W3AXL/Simple-GPSDO/kicad/simple-gpsdo-PCB-revD.png

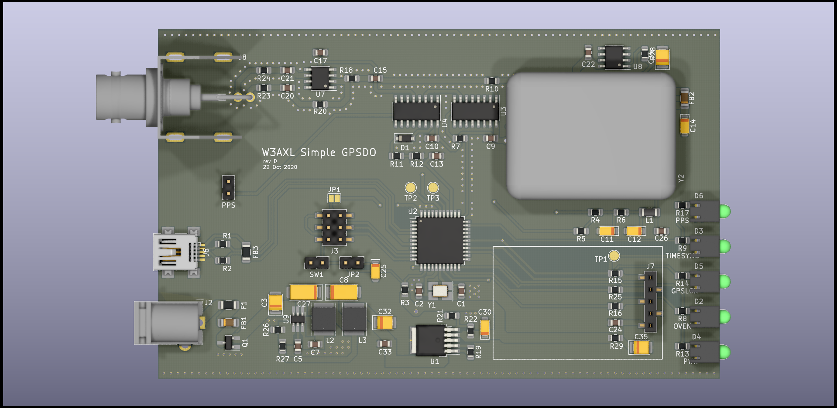
kicad/simple-gpsdo-PCB-revD.png
