W3AXL/Simple-GPSDO/kicad/board-model/board-revC.png

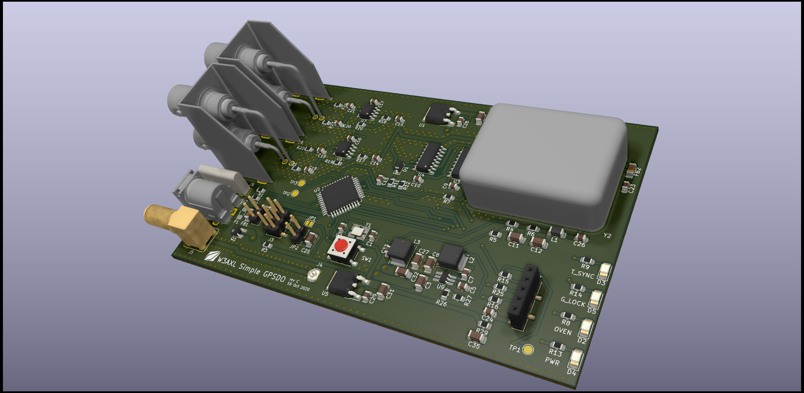
kicad/board-model/board-revC.png
