W3AXL/Simple-GPSDO/cad/render-back.png

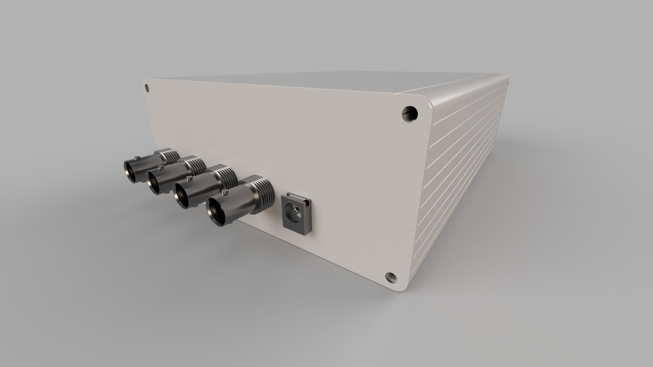
cad/render-back.png
