W3AXL/Simple-GPSDO/cad/render-front-2.png

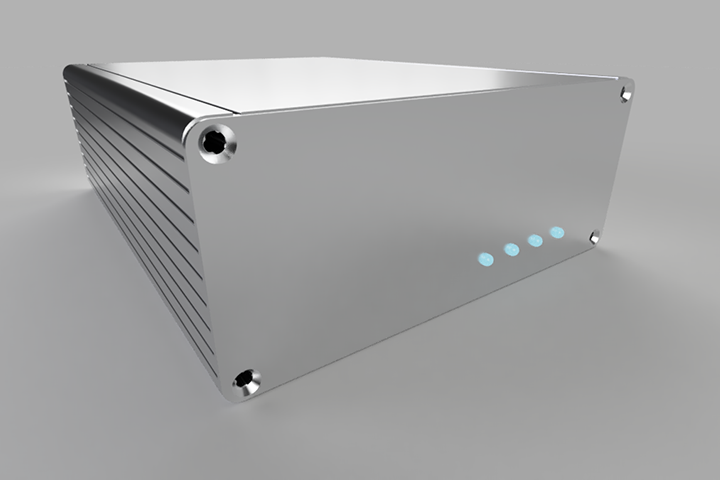
cad/render-front-2.png
