W3AXL/Simple-GPSDO/cad/render-front.PNG

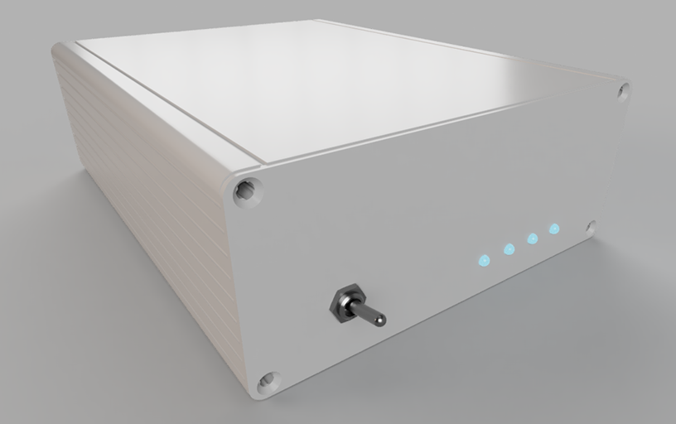
cad/render-front.PNG
