W3AXL/Simple-GPSDO/kicad/board-model/board-small.png

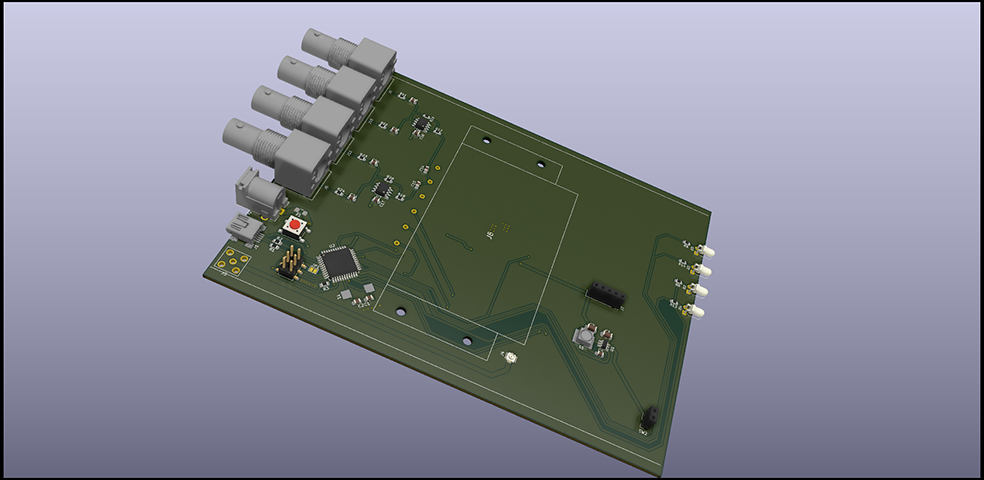
kicad/board-model/board-small.png
