W3AXL/Simple-GPSDO/cad/Enclosure Front Panel.stl

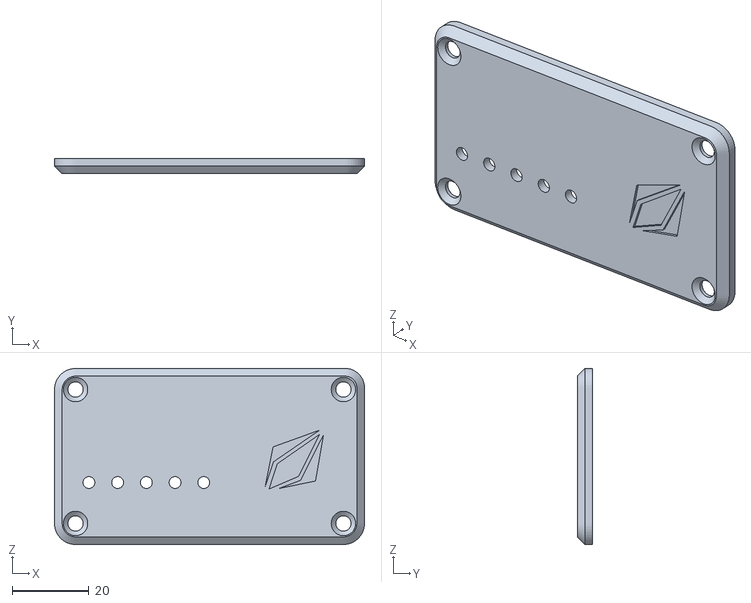
[picture p20: CAD file, 2021-11-03]
cad/Enclosure Front Panel.stl
81.0 x 4.00 x 46.0
