W3AXL/Simple-GPSDO/kicad/3d/934CB.STEP

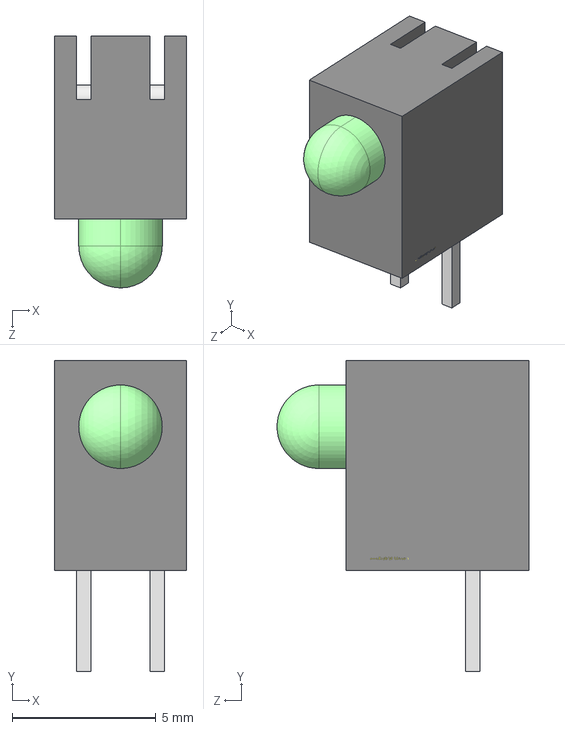
[picture p21: CAD file, 2021-10-23]
kicad/3d/934CB.STEP
4.60 x 10.8 x 8.75 mm
