W3AXL/Simple-GPSDO/kicad/HI1206P121R-10_LRD.step

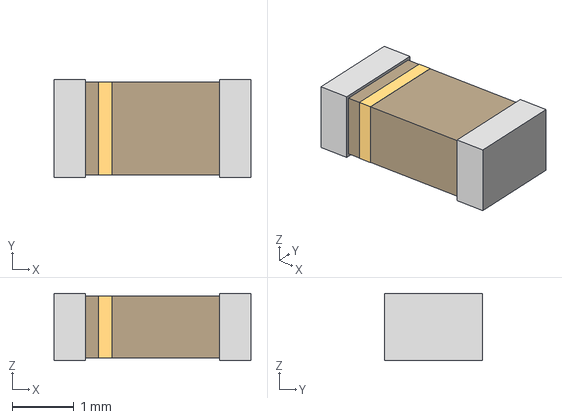
[picture p22: CAD file, 2020-09-25]
kicad/HI1206P121R-10_LRD.step
3.20 x 1.60 x 1.09 mm
