W3AXL/Simple-GPSDO/cad/Enclosure Rear Panel.stl

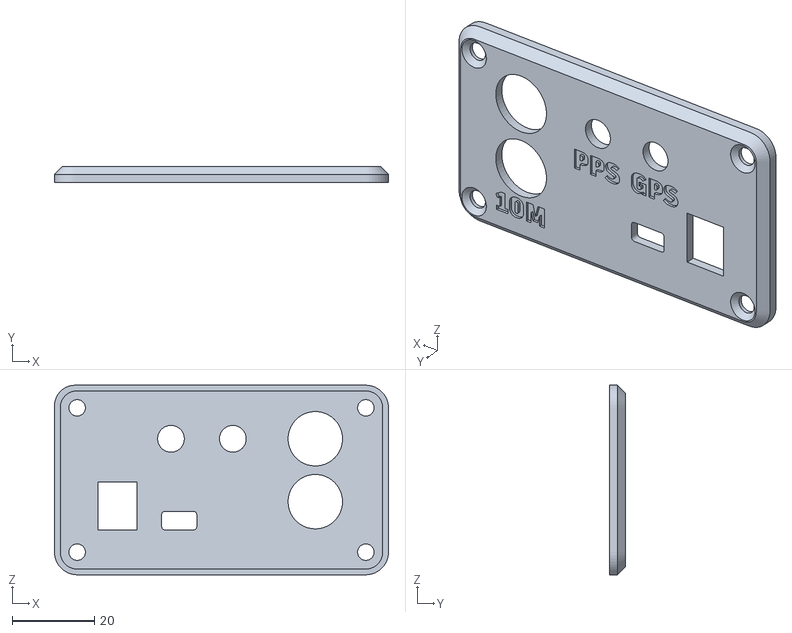
[picture p23: CAD file, 2021-11-03]
cad/Enclosure Rear Panel.stl
81.0 x 4.00 x 46.0
