W3AXL/Simple-GPSDO/kicad/Bliley NV47X v1.step

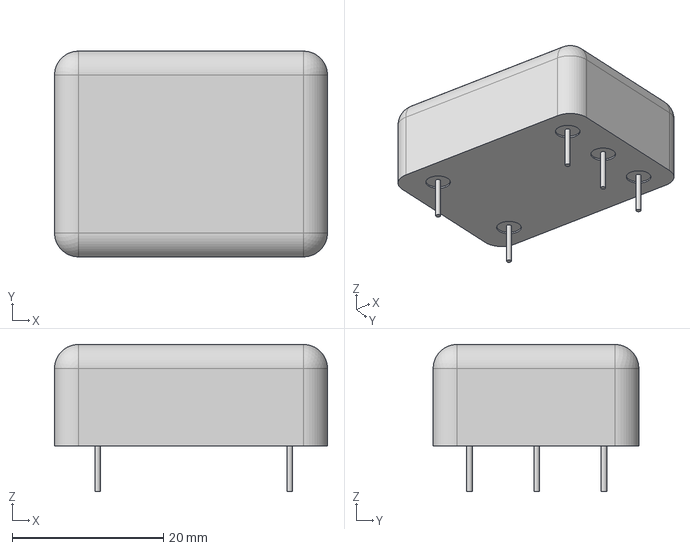
[picture p24: CAD file, 2020-09-24]
kicad/Bliley NV47X v1.step
36.1 x 27.2 x 19.5 mm
