W3AXL/Simple-GPSDO/cad/c-3-1478955-0-c-3d.stp

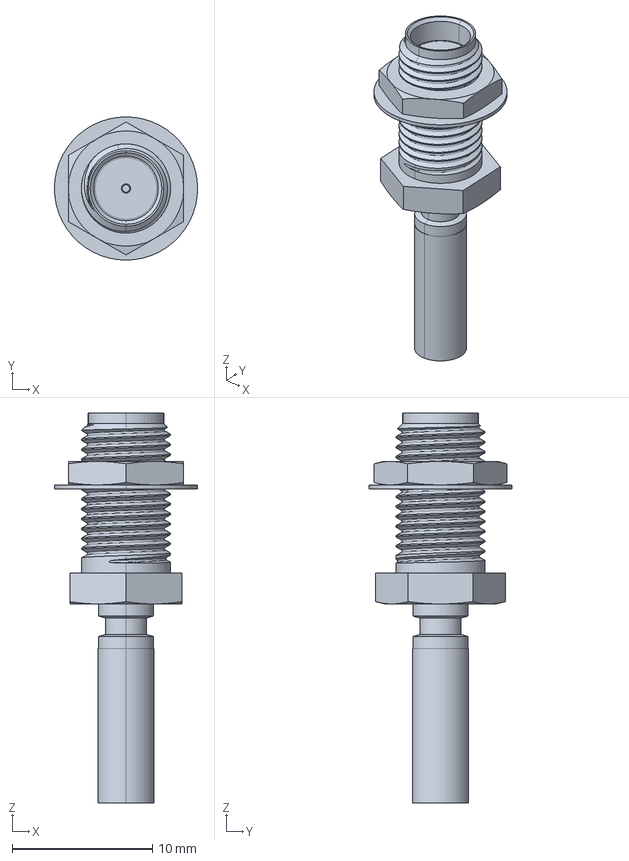
[picture p25: CAD file, 2021-10-23]
cad/c-3-1478955-0-c-3d.stp
10.2 x 10.2 x 27.8 mm
