W3AXL/Simple-GPSDO/kicad/RF2-49B-T-00-50-G-HDW v8.step

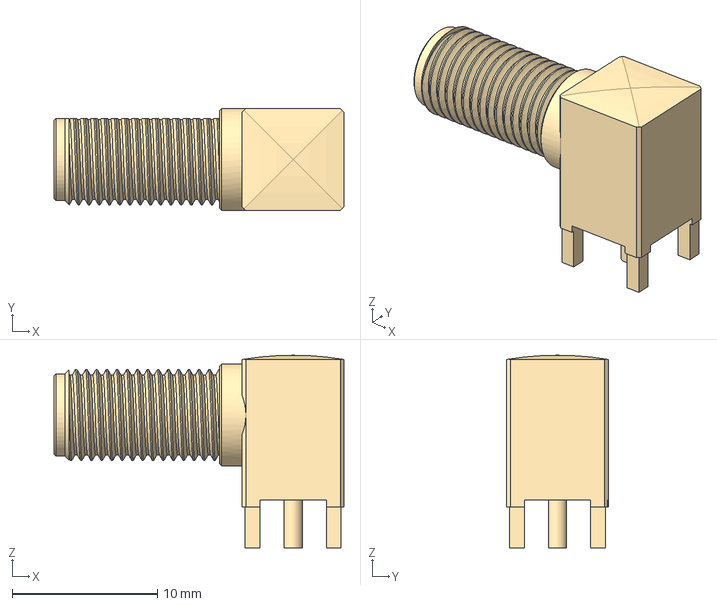
[picture p26: CAD file, 2020-09-24]
kicad/RF2-49B-T-00-50-G-HDW v8.step
20.0 x 7.01 x 13.3 mm
