W3AXL/Simple-GPSDO/cad/Q End Panel.stp

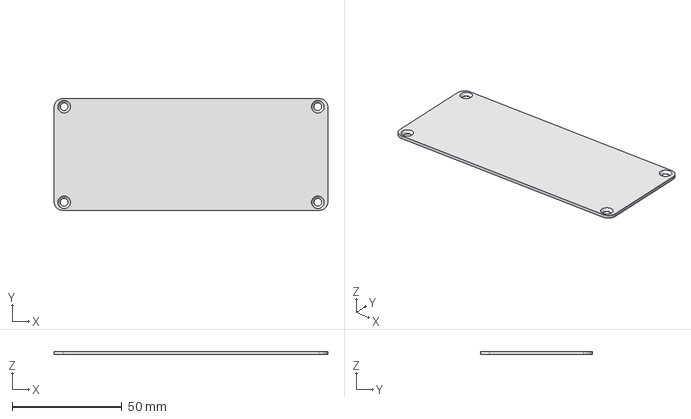
[picture p27: CAD file, 2020-09-19]
cad/Q End Panel.stp
124.8 x 50.9 x 1.45 mm
