W3AXL/Simple-GPSDO/kicad/IND_NRS5030_TAY.step

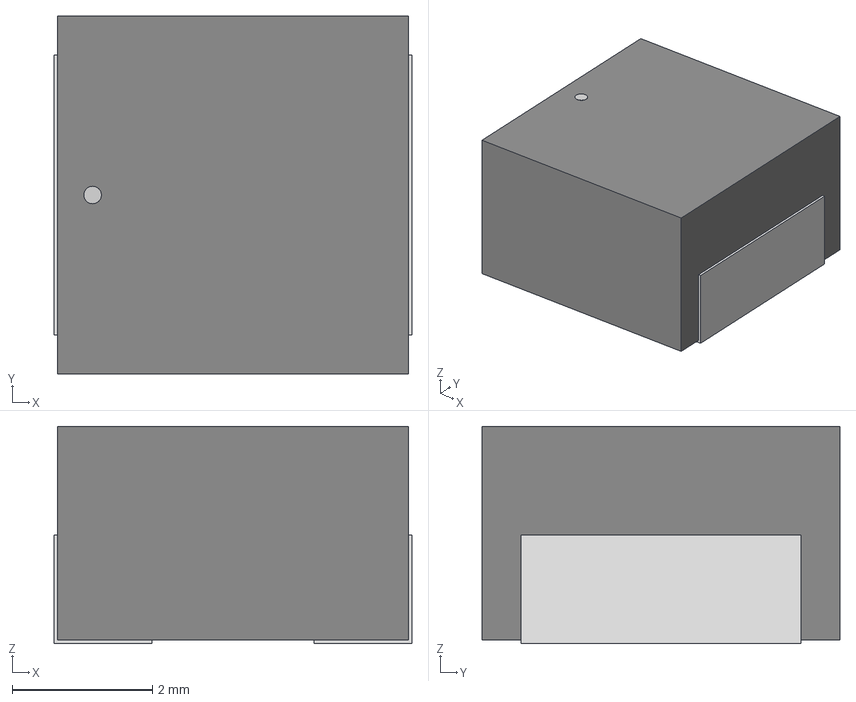
[picture p28: CAD file, 2020-09-24]
kicad/IND_NRS5030_TAY.step
5.11 x 5.11 x 3.10 mm
