W3AXL/Simple-GPSDO/cad/Q Bezel Open.stp

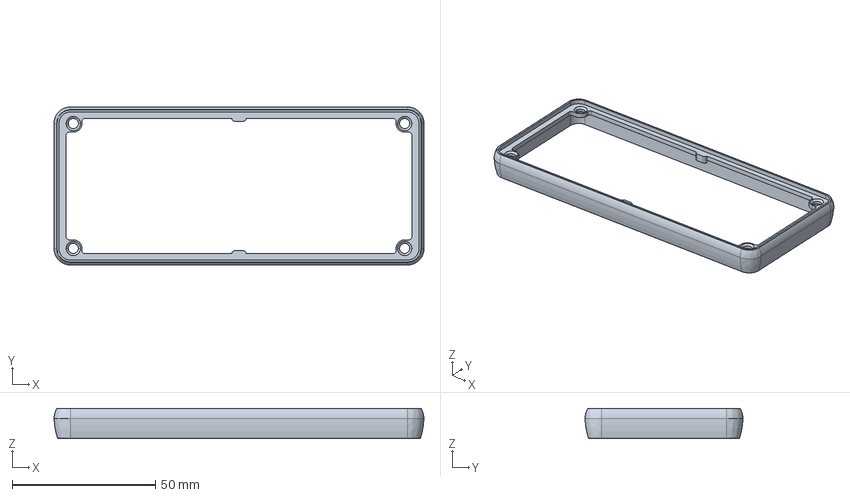
[picture p29: CAD file, 2020-09-19]
cad/Q Bezel Open.stp
129.0 x 55.1 x 10.5 mm
