W3AXL/Simple-GPSDO/cad/Q Extrusion 160mm.stp

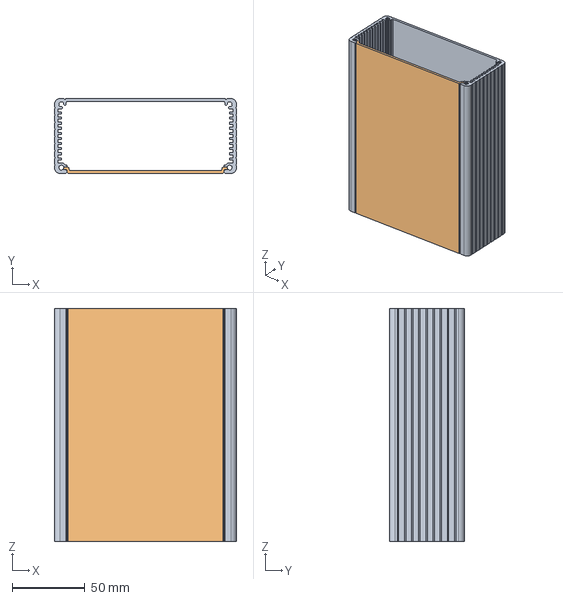
[picture p30: CAD file, 2020-09-19]
cad/Q Extrusion 160mm.stp
125.0 x 51.5 x 160.0 mm
