W3AXL/Simple-GPSDO/kicad/KUSBX-SL-CS1N14-B v8.step

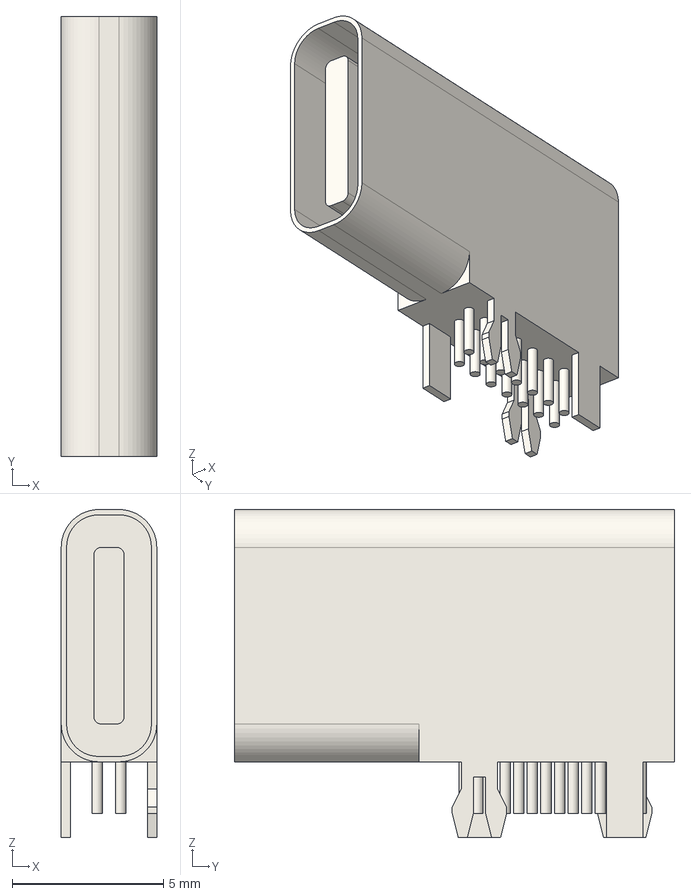
[picture p31: CAD file, 2020-09-24]
kicad/KUSBX-SL-CS1N14-B v8.step
3.16 x 14.6 x 10.8 mm
