W3AXL/Simple-GPSDO/kicad/3d/65100516121.stp

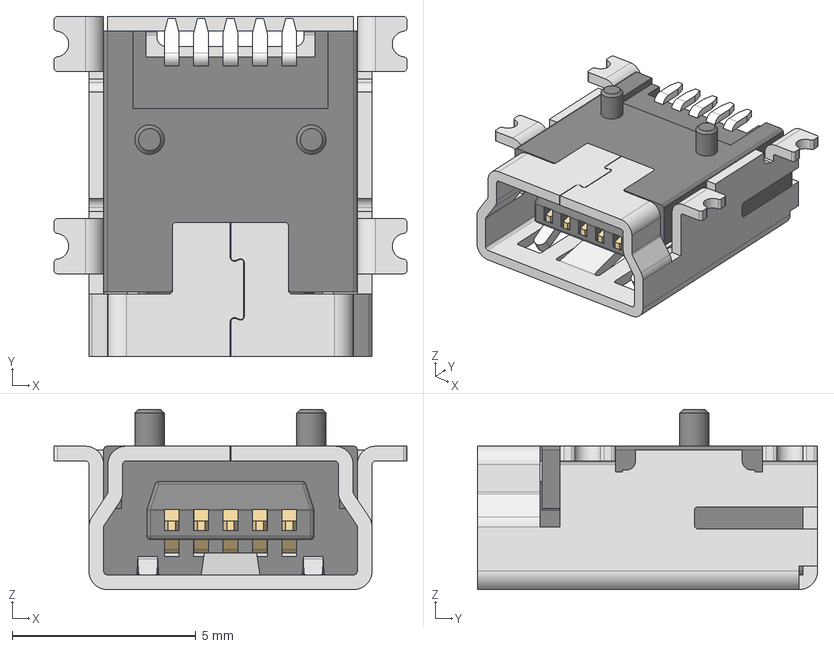
[picture p32: CAD file, 2021-10-23]
kicad/3d/65100516121.stp
9.60 x 9.25 x 4.90 mm
Shielding
Insulator
Pin_1 x 5
