W3AXL/Simple-GPSDO/cad/1455K1201.stp

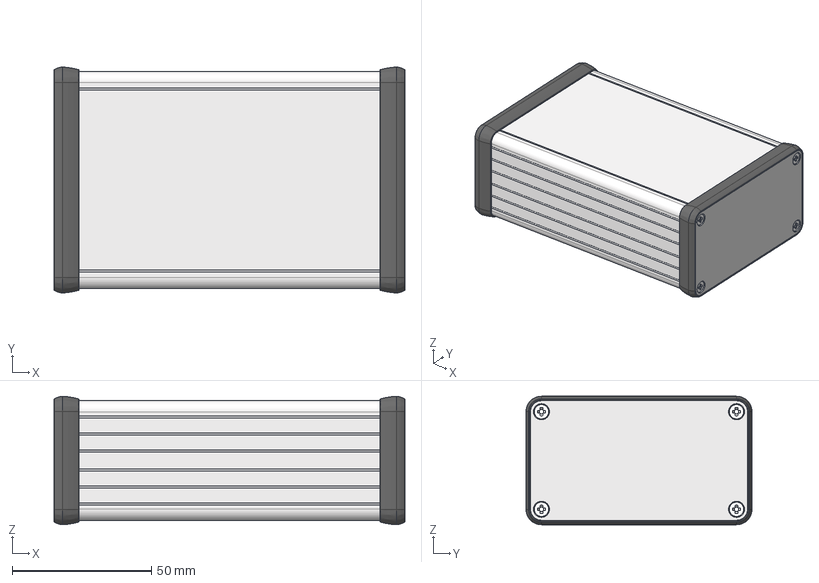
[picture p33: CAD file, 2020-09-24]
cad/1455K1201.stp
126.0 x 81.1 x 46.1 mm
K Channel Extrusion 120mmt
K Cap Extrusion 120mm
K Bezel Open x 2
K End Plate x 2
1455 screw x 8
