W3AXL/Simple-GPSDO/kicad/734153980.stp

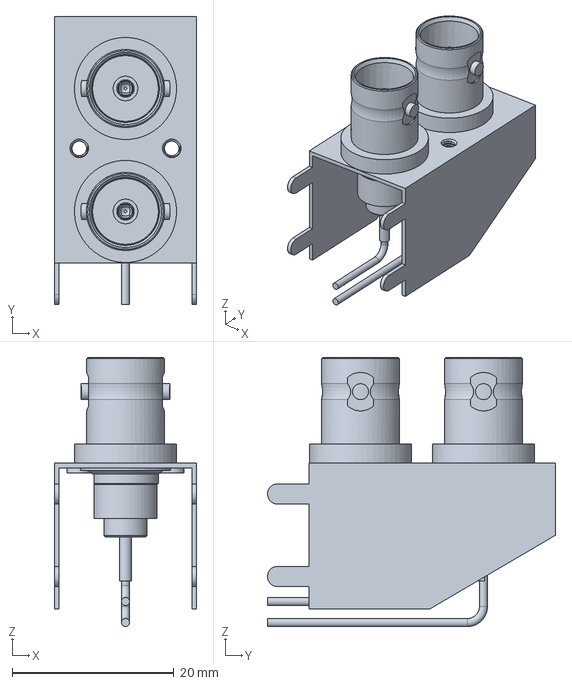
[picture p34: CAD file, 2020-09-24]
kicad/734153980.stp
17.6 x 35.6 x 33.3 mm
