W3AXL/Simple-GPSDO/(list of files, cad)

Other CAD files:
kicad/RF2-49B-T-00-50-G-HDW.stl
kicad/KUSBX-SL-CS1N14-B v6.step
