W3AXL/Simple-GPSDO/Pin Changes for rev B.txt

Pin Changes for rev B

PD6 (26) - New 5MHz Input
PD4 (25) - New PPS Input

PC6 (31) - New POWER_OK LED
PB4 (28) - New GPS_LOCK LED
PD1 (19) - New OVEN_TEMP LED
