W3AXL/Simple-GPSDO/(threads)

Thread 1 (2020-09-24):

Schematic updates to rev C

W3AXL, 2020-09-24:
Ongoing list of updates needed to the rev C schematic/PCB

- [x] Switch 33uH inductor to 3.3uH to avoid control loop instability and noise pickup
- [x] Add additional filtering on output of buck converter (second 3.3uH inductor plus caps to ground)
- [x] Reverse Polarity Protection on 12V input (PFET)
- [x] PPS connector

W3AXL, 2020-09-24:
Checklist for closure of ticket:
- [ ] Schematic Updated, Error Checked, Footprints Assigned
- [ ] Board Updated, Layout Error Checked
- [ ] BOM updated with component changes/additions

W3AXL, 2020-09-25:
Couple more small changes suggested by dbldutch over at eevblog forums

- [ ] Small series resistor and capacitor inline with supply to NEO GPS module to reduce 1PPS bouncing
- [ ] Fan control circuit and unpopulated footprints
- [ ] Resistor + capacitor on data line of LM35

W3AXL, 2020-10-16:
Deferring fan control to a future revision

Closed 2020-10-16.
