W3AXL/Simple-GPSDO/kicad/sch/revE/simple-gpsdo.pdf

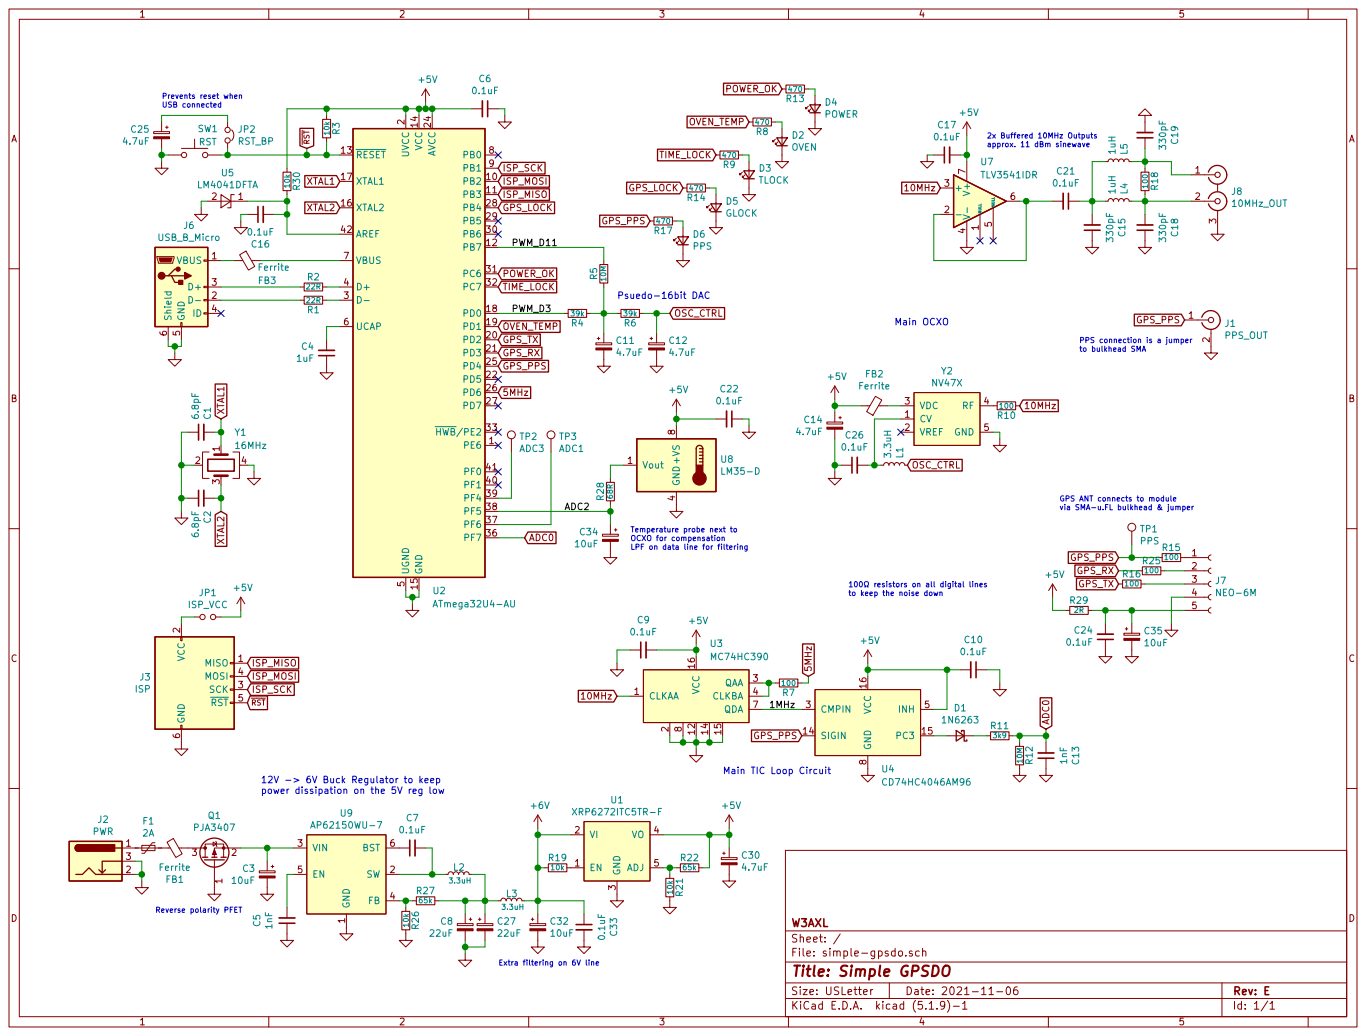
[picture p35: page 1]

2 PD2 20 PD3 21 PD5 22 AVCC 24 PD4 25 PD6 26 PD7 27 PB4 28 PB5 29 D- 3 PB6 30 PC6 31 PC7 32 HWB/PE2 33 PF7 36 PF6 37 PF5 38 PF4 39 D+ 4 PF1 40 PF0 41 AREF 42 UGND

2x Buffered 10MHz Outputs approx. 11 dBm sinewave

to bulkhead SMA Psuedo-16bit DAC

PPS connection is a jumper

GPS ANT connects to module
via SMA-u.FL bulkhead & jumper

100 resistors on all digital lines

2 SCK 3 MOSI 4 RST 5 GND

1 SW 2 VIN 3 FB 4 EN 5 BST 6 U9 AP62150WU-7 SIGIN 14 PC3 15 VCC 16 CMPIN 3

12V -> 6V Buck Regulator to keep
power dissipation on the 5V reg low

File: simple-gpsdo.sch Sheet: / W3AXL

Extra filtering on 6V line

Id: 1/1 Title: Simple GPSDO
