W3AXL/Simple-GPSDO/kicad/sch/revC/simple-gpsdo.pdf

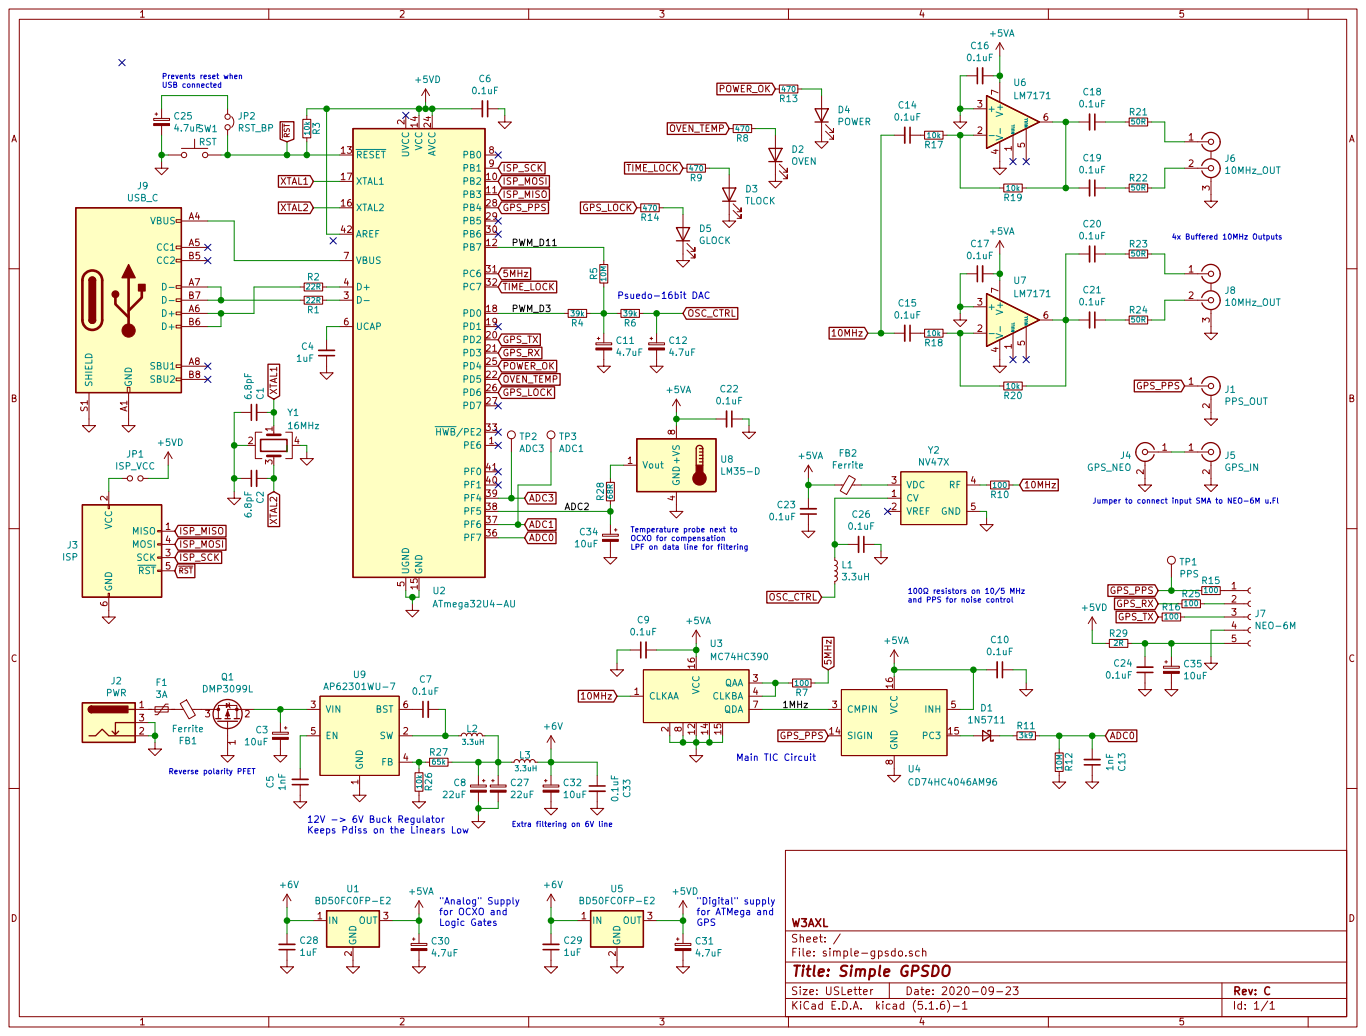
[picture p36: page 1]

Prevents reset when USB connected

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

Jumper to connect input SMA to NEO-6M u.Fl 4x Buffered 10MHz Outputs

2 SCK 3 MOSI 4 RST 5 GND

ISP_MISO
ISP_MOSI
LPF on data line for filtering Reverse polarity PFET
ISP_SCK
RST

100 resistors on 10/5 MHz and PPS for noise control 12V -> 6V Buck Regulator

1 SW 2 VIN 3 FB 4 EN 5 BST 6 U9 AP62301WU-7

Keeps Pdiss on the Linears Low

"Digital" supply
for ATMega and GPS

File: simple-gpsdo.sch Sheet: / W3AXL

Id: 1/1 Title: Simple GPSDO
