W3AXL/Simple-GPSDO/sim/Output Amplifier/output-amplifier-sim.asc

C4: cap; 0.1µ
C7: cap; 330p
C8: cap; 330p
C9: cap; 330p
L3: ind; 1µ; Rser=400m
L4: ind; 1µ; Rser=400m
R1: res; 50
R2: res; 50
R6: res; 100
U1: TLV354
V1: voltage; 5V
V2: voltage; PULSE(0 4 0 6n 6n 50n 100n); Rser=127
Named nets: 0, OUT1, OUT2, IN, +5V, SINE
.tran 0 100.5u 100u
