W3AXL/Simple-GPSDO/sim/OSC Control Amp/control-amp.asc

C1: cap; 4.7µ
C2: cap; 4.7µ
R1: res; 10Meg
R2: res; 39k
R3: res; 39k
R4: res; 100
V3: voltage; PULSE(0 5 0 0 0 1m 2m)
V4: voltage; PULSE(0 5 0 0 0 1m 2m)
Named nets: 0, DAC
.tran 5
