W3AXL/Simple-GPSDO/kicad/simple-gpsdo.kicad_pcb

## KiCad design kicad/simple-gpsdo.kicad_pcb (2021-11-11)

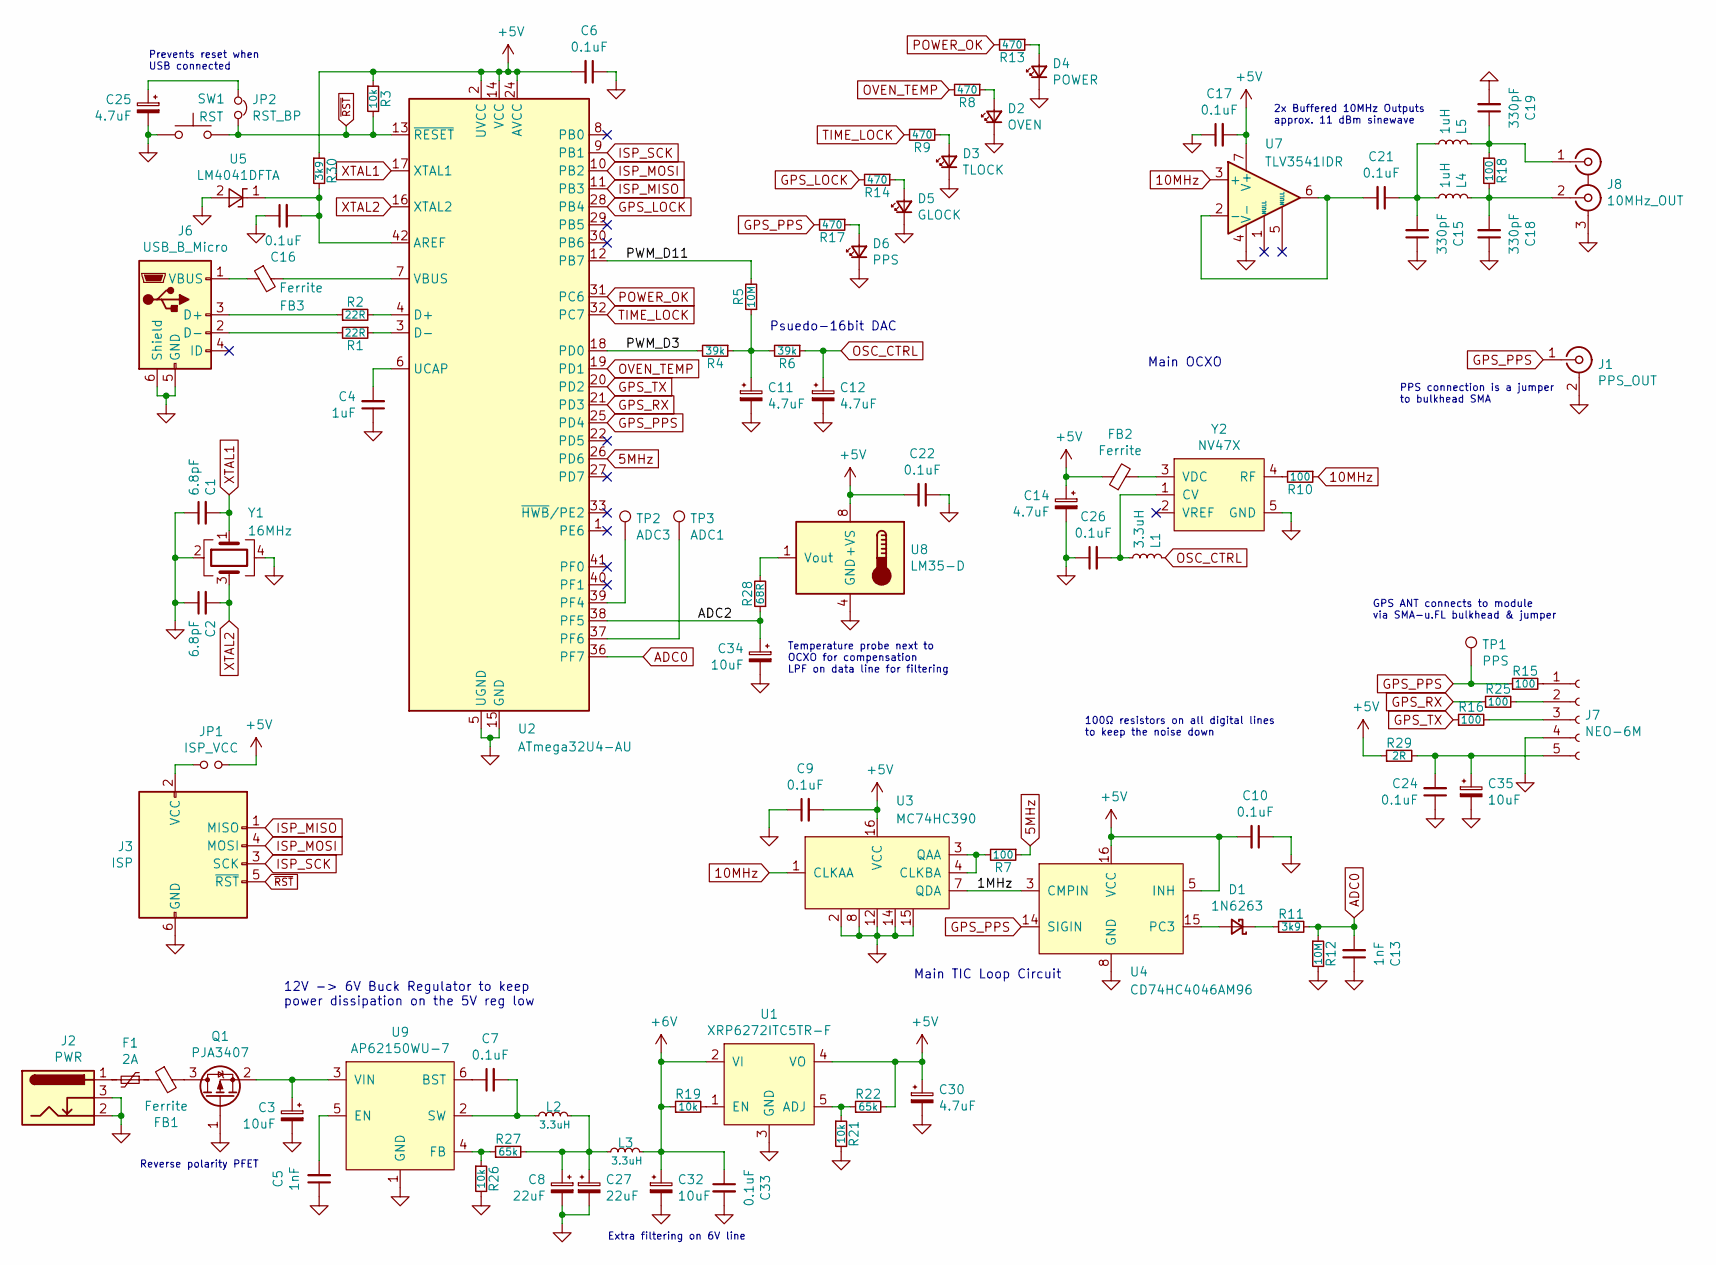
[picture p37: schematic simple-gpsdo.sch, Simple GPSDO]

Parts:
C1, C2: 6.8pF; C_0805_2012Metric_Pad1.15x1.40mm_HandSolder
C3, C32, C34, C35: 10uF; CP_EIA-3528-15_AVX-H_Pad1.50x2.35mm_HandSolder
C4: 1uF; C_0805_2012Metric_Pad1.15x1.40mm_HandSolder
C5, C13: 1nF; C_0805_2012Metric_Pad1.15x1.40mm_HandSolder
C6, C7, C9, C10, C16, C17, C21, C22, C24, C26, C33: 0.1uF; C_0805_2012Metric_Pad1.15x1.40mm_HandSolder
C8, C27: 22uF; CP_EIA-6032-20_AVX-F_Pad2.25x2.35mm_HandSolder
C11, C12, C14, C25, C30: 4.7uF; CP_EIA-3216-10_Kemet-I_Pad1.58x1.35mm_HandSolder
C15, C18, C19: 330pF; C_0805_2012Metric_Pad1.15x1.40mm_HandSolder
D1: 1N6263; D_SOD-123
D2: OVEN; LED_D3.0mm_Horizontal_O1.27mm_Z2.0mm
D3: TLOCK; LED_D3.0mm_Horizontal_O1.27mm_Z2.0mm
D4: POWER; LED_D3.0mm_Horizontal_O1.27mm_Z2.0mm
D5: GLOCK; LED_D3.0mm_Horizontal_O1.27mm_Z2.0mm
D6: PPS; LED_D3.0mm_Horizontal_O1.27mm_Z2.0mm
F1: 2A; Fuse_1206_3216Metric_Pad1.42x1.75mm_HandSolder
FB1, FB2, FB3: Ferrite; Fuse_1206_3216Metric_Pad1.42x1.75mm_HandSolder
J1: PPS_OUT; PinHeader_2x01_P2.54mm_Vertical
J2: PWR; BarrelJack_CUI_PJ-102AH_Horizontal
J3: ISP; PinHeader_2x03_P2.54mm_Vertical_SMD
J6: USB_B_Micro; USB_Mini-B_Wuerth_65100516121_Horizontal
J7: NEO-6M; PinSocket_1x05_P2.54mm_Vertical_SMD_Pin1Left
J8: 10MHz_OUT; 734152980
JP1: ISP_VCC; SolderJumper-2_P1.3mm_Open_Pad1.0x1.5mm
JP2: RST_BP; PinHeader_1x02_P2.54mm_Vertical
L1: 3.3uH; L_1206_3216Metric_Pad1.42x1.75mm_HandSolder
L2, L3: 3.3uH; L_Taiyo-Yuden_NR-50xx_HandSoldering
L4, L5: 1uH; L_1206_3216Metric_Pad1.42x1.75mm_HandSolder
Q1: PJA3407; SOT-23_Handsoldering
R1, R2: 22R; R_0805_2012Metric_Pad1.15x1.40mm_HandSolder
R3, R19, R21, R26: 10k; R_0805_2012Metric_Pad1.15x1.40mm_HandSolder
R4, R6: 39k; R_0805_2012Metric_Pad1.15x1.40mm_HandSolder
R5, R12: 10M; R_0805_2012Metric_Pad1.15x1.40mm_HandSolder
R7, R10, R15, R16, R18, R25: 100; R_0805_2012Metric_Pad1.15x1.40mm_HandSolder
R8, R9, R13, R14, R17: 470; R_0805_2012Metric_Pad1.15x1.40mm_HandSolder
R11, R30: 3k9; R_0805_2012Metric_Pad1.15x1.40mm_HandSolder
R22, R27: 65k; R_0805_2012Metric_Pad1.15x1.40mm_HandSolder
R28: 68R; R_0805_2012Metric_Pad1.15x1.40mm_HandSolder
R29: 2R; R_0805_2012Metric_Pad1.15x1.40mm_HandSolder
SW1: RST; PinHeader_1x02_P2.54mm_Vertical
TP1: PPS; TestPoint_Pad_D2.0mm
TP2: ADC3; TestPoint_Pad_D2.0mm
TP3: ADC1; TestPoint_Pad_D2.0mm
U1: XRP6272ITC5TR-F; TO-252-5_TabPin3
U2: ATmega32U4-AU; TQFP-44_10x10mm_P0.8mm
U3: MC74HC390; SOIC-16_3.9x9.9mm_P1.27mm
U4: CD74HC4046AM96; SOIC-16_3.9x9.9mm_P1.27mm
U5: LM4041DFTA; SOT-23_Handsoldering
U7: TLV3541IDR; SOIC-8_3.9x4.9mm_P1.27mm
U8: LM35-D; SOIC-8_3.9x4.9mm_P1.27mm
U9: AP62150WU-7; TSOT-23-6_HandSoldering
Y1: 16MHz; Crystal_SMD_SeikoEpson_TSX3225-4Pin_3.2x2.5mm_HandSoldering
Y2: NV47X; CO-08

Connections:
5MHz: R7.1, U2.26 (PD6)
10MHz: R10.1, U3.1 (CLKAA), U7.3 (+)
+5V: C6.2, C9.2, C10.2, C14.1, C17.2, C22.2, C30.1, FB2.1, JP1.2, R3.1, R22.2, R29.1, R30.1, U1.4 (VO), U2.2 (UVCC), U2.14 (VCC), U2.24 (AVCC), U2.34 (VCC), U2.44 (AVCC), U3.16 (VCC), U4.5 (INH), U4.16 (VCC), U7.7 (V+), U8.8 (+VS)
+6V: C32.1, C33.1, L3.2, R19.1, U1.2 (VI)
/1MHz: U3.7 (QDA), U4.3 (CMPIN)
/ADC2: C34.1, R28.1, U2.38 (PF5)
/PWM_D3: R4.2, U2.18 (PD0)
/PWM_D11: R5.2, U2.12 (PB7)
ADC0: C13.2, R11.2, R12.1, U2.36 (PF7)
GND: C1.1, C2.1, C3.2, C4.1, C5.1, C6.1, C8.2, C9.1, C10.1, C11.2, C12.2, C13.1, C14.2, C15.1, C16.1, C17.1, C18.1, C19.2, C22.1, C24.1, C25.2, C26.1, C27.2, C30.2, C32.2, C33.2, C34.2, C35.2, D2.1 (K), D3.1 (K), D4.1 (K), D5.1 (K), D6.1 (K), J1.2 (Ext), J2.2, J2.3, J3.6 (GND), J6.5 (GND), J6.6 (Shield), J7.4, J8.3 (EXT), Q1.1 (G), R12.2, R21.2, R26.2, SW1.1, U1.3 (GND), U2.5 (UGND), U2.15 (GND), U2.23 (GND), U2.35 (GND), U2.43 (GND), U3.2, U3.8, U3.12, U3.14, U3.15, U4.8 (GND), U5.2 (A), U7.4 (V-), U8.4 (GND), U9.1 (GND), Y1.2, Y1.4, Y2.5 (GND)
GPS_LOCK: R14.2, U2.28 (PB4)
GPS_PPS: J1.1 (In), R15.1, R17.2, TP1.1, U2.25 (PD4), U4.14 (SIGIN)
GPS_RX: R25.1, U2.21 (PD3)
GPS_TX: R16.1, U2.20 (PD2)
ISP_MISO: J3.1 (MISO), U2.11 (PB3)
ISP_MOSI: J3.4 (MOSI), U2.10 (PB2)
ISP_SCK: J3.3 (SCK), U2.9 (PB1)
unnamed: C3.1, Q1.2 (S), U9.3 (VIN)
unnamed: C4.2, U2.6 (UCAP)
unnamed: C5.2, U9.5 (EN)
unnamed: C7.1, U9.6 (BST)
unnamed: C7.2, L2.1, U9.2 (SW)
unnamed: C11.1, R4.1, R5.1, R6.2
unnamed: C15.2, C21.1, L4.2, L5.2
unnamed: C16.2, R30.2, U2.42 (AREF), U5.1 (K)
unnamed: C18.2, J8.2 (IN2), L4.1, R18.2
unnamed: C19.1, J8.1 (IN1), L5.1, R18.1
unnamed: C21.2, U7.2 (-), U7.6
unnamed: C24.2, C35.1, J7.5, R29.2
unnamed: C25.1, JP2.1
unnamed: C26.2, L1.2, Y2.1 (CV)
unnamed: C8.1, C27.1, L2.2, L3.1, R27.2
unnamed: D1.1 (K), R11.1
unnamed: D1.2 (A), U4.15 (PC3)
unnamed: D2.2 (A), R8.1
unnamed: D3.2 (A), R9.1
unnamed: D4.2 (A), R13.1
unnamed: D5.2 (A), R14.1
unnamed: D6.2 (A), R17.1
unnamed: F1.1, FB1.1
unnamed: F1.2, J2.1
unnamed: FB1.2, Q1.3 (D)
unnamed: FB2.2, Y2.3 (VDC)
unnamed: FB3.1, J6.1 (VBUS)
unnamed: FB3.2, U2.7 (VBUS)
unnamed: J3.2 (VCC), JP1.1
unnamed: J6.2 (D-), R1.2
unnamed: J6.3 (D+), R2.1
unnamed: J7.1, R15.2
unnamed: J7.2, R25.2
unnamed: J7.3, R16.2
unnamed: R1.1, U2.3 (D-)
unnamed: R2.2, U2.4 (D+)
unnamed: R7.2, U3.3 (QAA), U3.4 (CLKBA)
unnamed: R10.2, Y2.4 (RF)
unnamed: R19.2, U1.1 (EN)
unnamed: R21.1, R22.1, U1.5 (ADJ)
unnamed: R26.1, R27.1, U9.4 (FB)
unnamed: R28.2, U8.1 (Vout)
unnamed: TP2.1, U2.39 (PF4)
unnamed: TP3.1, U2.37 (PF6)
OSC_CTRL: C12.1, L1.1, R6.1
OVEN_TEMP: R8.2, U2.19 (PD1)
POWER_OK: R13.2, U2.31 (PC6)
TIME_LOCK: R9.2, U2.32 (PC7)
XTAL1: C1.2, U2.17 (XTAL1), Y1.1
XTAL2: C2.2, U2.16 (XTAL2), Y1.3
~RST: J3.5 (~RST), JP2.2, R3.2, SW1.2, U2.13 (~RESET)

Notes on the sheet:
2x Buffered 10MHz Outputs approx. 11 dBm sinewave
100Ω resistors on all digital lines to keep the noise down
Psuedo-16bit DAC
Prevents reset when USB connected
Main TIC Loop Circuit
Temperature probe next to OCXO for compensation LPF on data line for filtering
Main OCXO
12V -> 6V Buck Regulator to keep power dissipation on the 5V reg low
Extra filtering on 6V line
Reverse polarity PFET
GPS ANT connects to module via SMA-u.FL bulkhead & jumper
PPS connection is a jumper to bulkhead SMA

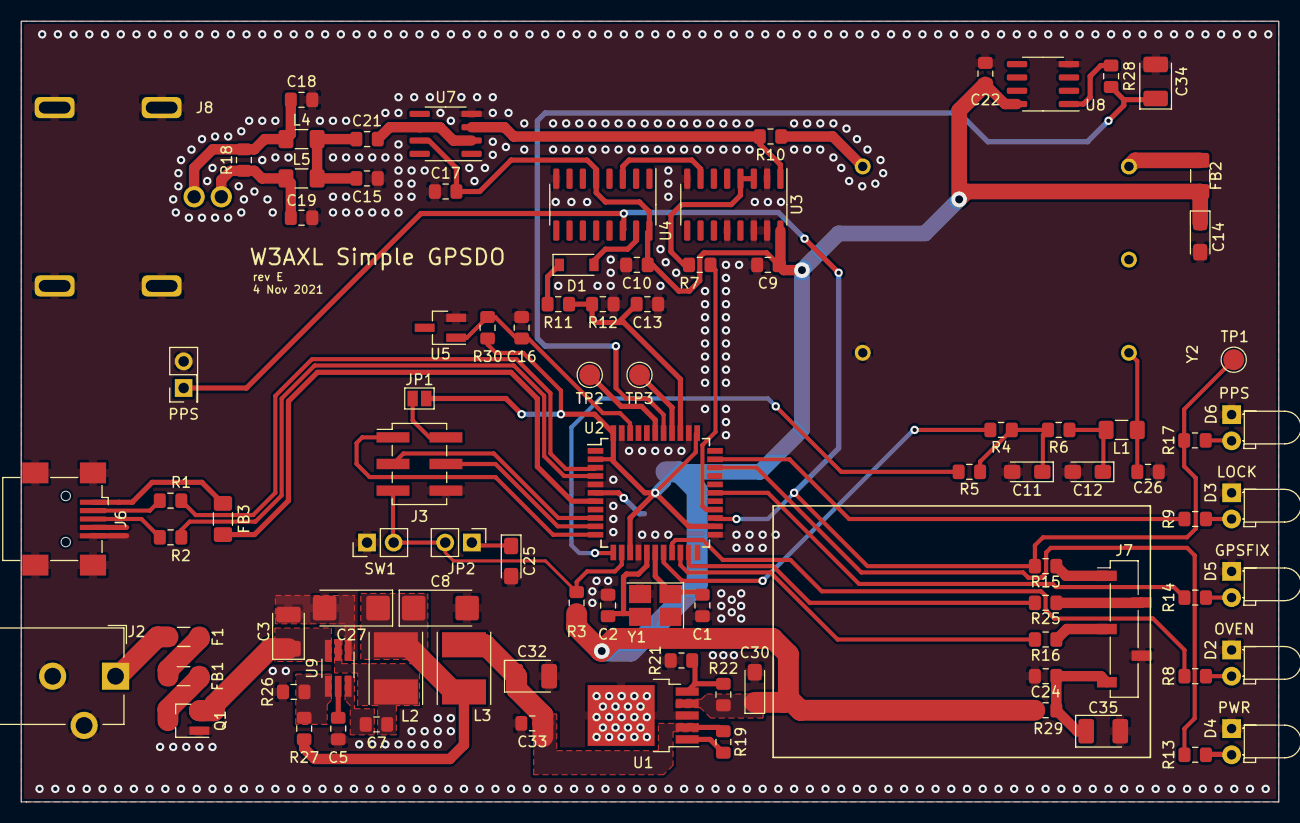
[picture p38: board simple-gpsdo.kicad_pcb from above]

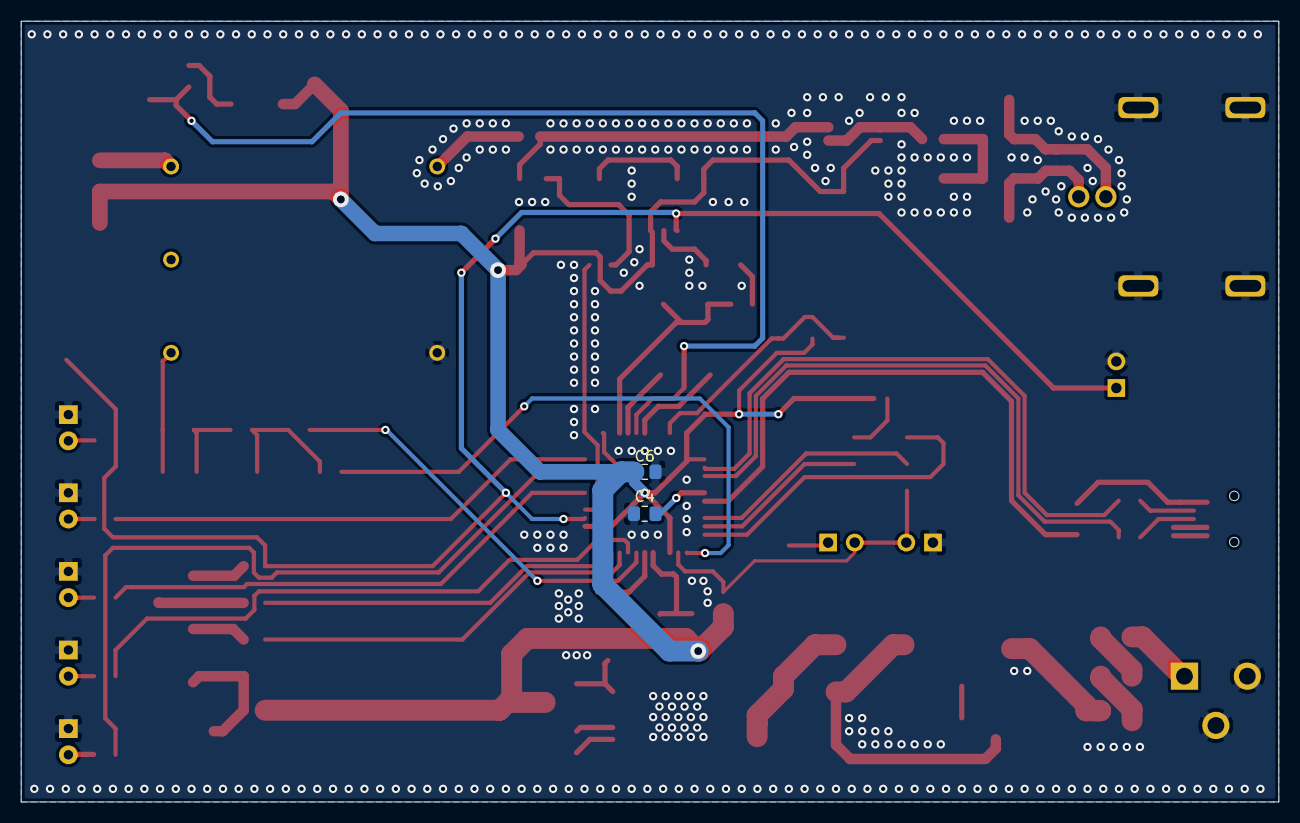
[picture p39: board simple-gpsdo.kicad_pcb from below]

Board: 2 copper layers, 120.0 x 74.5 mm, 95 parts (2 on the bottom side), 68 nets.
