W3AXL/Simple-GPSDO/(commit log)

2020-09-15 initial github commit
    kicad schematic WIP
    [simple-gpsdo.kicad_pcb, simple-gpsdo.sch]
2020-09-17 kicad schematic work
    [simple-gpsdo.sch]
2020-09-17 added 74HCxx symbols
    [simple-gpsdo.sch]
2020-09-19 finished schematic, started PCB
    [BOM.xlsx, simple-gpsdo.sch]
2020-09-19 finished initial schematic and PCB
    [simple-gpsdo.kicad_pcb]
2020-09-19 cad stuff
    [Q Bezel Open.stp, Q End Panel.stp, Q Extrusion 160mm.stp]
2020-09-19 more media
    [simple-gpsdo.sch]
2020-09-21 major schematic change, PCB not yet updated
    [BOM-revB.csv, BOM-revB.xlsx, BOM.xlsx, simple-gpsdo.sch]
2020-09-21 more work on updated Rev B schematic/pcb
    [BOM-revB.csv, BOM-revB.xlsx, BOM.xlsx, simple-gpsdo.kicad_pcb, simple-gpsdo.sch]
2020-09-22 more PCB work (still not done)
    [simple-gpsdo.kicad_pcb, simple-gpsdo.sch]
2020-09-23 more pcb work
    [simple-gpsdo.kicad_pcb]
2020-09-23 pcb work is hard
    [simple-gpsdo.kicad_pcb, simple-gpsdo.sch]
2020-09-24 changed regulator setup, way more board work
    [BOM-revB.xlsx, simple-gpsdo.kicad_pcb, simple-gpsdo.sch]
2020-09-24 new revision, new BOM
    [BOM-revC.xlsx, simple-gpsdo.kicad_pcb, simple-gpsdo.sch]
2020-09-24 finalizing PCB, added 3D models
    [734153980.stp, BOM-revC.xlsx, IND_NRS5030_TAY.step, KUSBX-SL-CS1N14-B v6.step, KUSBX-SL-CS1N14-B v8.step, RF2-49B-T-00-50-G-HDW v8.step, RF2-49B-T-00-50-G-HDW.stl, simple-gpsdo.kicad_pcb]
2020-09-24 finalizing rev C PCB
    [1455K1201.stp, Bliley NV47X v1.step, simple-gpsdo.kicad_pcb]
2020-09-24 finalizing schematic
    [simple-gpsdo.sch]
2020-09-24 initial work on schematic updates
    [BOM-revC.xlsx, simple-gpsdo.sch]
2020-09-25 added extra buck filtering
    [BOM-revB.xlsx, BOM-revC.xlsx, BOM.xlsx, simple-gpsdo.kicad_pcb, simple-gpsdo.sch]
2020-09-25 finalizing revC schematic and board
    [BOM.xlsx, HI1206P121R-10_LRD.step, simple-gpsdo.kicad_pcb, simple-gpsdo.sch]
2020-09-25 final board and sch exports
2020-09-25 added resistor/cap to NEO power in sch
    [simple-gpsdo.sch]
2020-09-25 added filtering to LM35
    [simple-gpsdo.kicad_pcb, simple-gpsdo.sch]
2020-09-30 added fan control to schematic, board work still needed
    [simple-gpsdo.kicad_pcb, simple-gpsdo.sch]
2020-10-16 finalizing revC updates
    [simple-gpsdo-B_Cu.gbr, simple-gpsdo-B_Mask.gbr, simple-gpsdo-B_SilkS.gbr, simple-gpsdo-Edge_Cuts.gbr, simple-gpsdo-F_Cu.gbr, simple-gpsdo-F_Mask.gbr, simple-gpsdo-F_SilkS.gbr, simple-gpsdo-NPTH.drl]
2020-10-16 updated BOM with new components
    [BOM.xlsx]
2020-10-16 updated board with silkscreen logo and text
    [simple-gpsdo-B_Cu.gbr, simple-gpsdo-B_Mask.gbr, simple-gpsdo-B_SilkS.gbr, simple-gpsdo-Edge_Cuts.gbr, simple-gpsdo-F_Cu.gbr, simple-gpsdo-F_Mask.gbr, simple-gpsdo-F_SilkS.gbr, simple-gpsdo-NPTH.drl]
2020-10-16 updated pictures, moved BNC jacks slightly inward
    [simple-gpsdo-B_Cu.gbr, simple-gpsdo-B_Mask.gbr, simple-gpsdo-B_SilkS.gbr, simple-gpsdo-Edge_Cuts.gbr, simple-gpsdo-F_Cu.gbr, simple-gpsdo-F_Mask.gbr, simple-gpsdo-F_SilkS.gbr, simple-gpsdo-NPTH.drl]
2021-04-06 schematic cleanup and re-plot of gerber files
    [simple-gpsdo-B_Cu.gbr, simple-gpsdo-B_Mask.gbr, simple-gpsdo-B_SilkS.gbr, simple-gpsdo-Edge_Cuts.gbr, simple-gpsdo-F_Cu.gbr, simple-gpsdo-F_Mask.gbr, simple-gpsdo-F_SilkS.gbr, simple-gpsdo-NPTH.drl]
2021-10-22 cleaned up schematic and replaced AP63203 with AP62201
    [simple-gpsdo.sch]
2021-10-22 Revert "cleaned up schematic and replaced AP63203 with AP62201"
    This reverts commit 2d2100cbd1b700602c63588ffeb895ea7c004985.
    [simple-gpsdo.sch]
2021-10-22 replaced excel BOM with CSV
    [BOM.csv, BOM.xlsx]
2021-10-22 finalized simple schematic, started PCB rework
    [simple-gpsdo.kicad_pcb, simple-gpsdo.sch]
2021-10-22 finalized new schematic and board
    [65100516121.stp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]
2021-10-22 Updated tantalum footprints, started new BOM
    [BOM.csv, simple-gpsdo-BOM.csv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]
2021-10-22 Changed 1N5711 to 1N6263 for availability
    [simple-gpsdo-BOM.csv, simple-gpsdo.sch]
2021-10-22 Replaced C23 (0.1uF) with C14 (4.7uF)
    [simple-gpsdo-BOM.csv, simple-gpsdo.kicad_pcb, simple-gpsdo.sch]
2021-10-22 Updated LEDs to proper right angle THT, including 3D models
    [65100516121.stp, 934CB.STEP, simple-gpsdo-BOM.csv, simple-gpsdo.kicad_pcb]
2021-10-22 Changed input fuse from 3A to 2A
    [simple-gpsdo-BOM.csv, simple-gpsdo.kicad_pcb, simple-gpsdo.sch]
2021-10-22 Changed input fuse from 3A to 2A (2/2)
2021-10-23 finalized rev D schematic
    [simple-gpsdo-BOM.csv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]
2021-10-23 updated board model and photo for rev D
2021-10-23 finalized schematic and PCB
    [simple-gpsdo-B_Cu.gbr, simple-gpsdo-B_Mask.gbr, simple-gpsdo-B_SilkS.gbr, simple-gpsdo-Edge_Cuts.gbr, simple-gpsdo-F_Cu.gbr, simple-gpsdo-F_Mask.gbr, simple-gpsdo-F_SilkS.gbr, simple-gpsdo-NPTH.drl]
2021-11-03 added new front & rear enclosure panels
    [Enclosure Front Panel.stl, Enclosure Rear Panel.stl]
2021-11-04 updated schematic with new pin assignment fixes
    [simple-gpsdo.sch]
2021-11-04 revision E updates
    added external 1.2 VREF
    connected UVCC to VCC
    switched pins for 5MHz, PPS, and LEDs to work properly
    [simple-gpsdo-B_Cu.gbr, simple-gpsdo-B_Mask.gbr, simple-gpsdo-B_SilkS.gbr, simple-gpsdo-Edge_Cuts.gbr, simple-gpsdo-F_Cu.gbr, simple-gpsdo-F_Mask.gbr, simple-gpsdo-F_SilkS.gbr, simple-gpsdo-NPTH.drl]
2021-11-04 Update Pin Changes for rev B.txt
2021-11-04 Using external bodged 1.2V-ish VREF in code
    [lars-code-improved.ino]
2021-11-04 Updates to output amplifier, added simulation
    [simple-gpsdo.sch]
2021-11-05 final schematic updates for new buffer amplifier
    [simple-gpsdo-B_Cu.gbr, simple-gpsdo-B_Mask.gbr, simple-gpsdo-B_SilkS.gbr, simple-gpsdo-Edge_Cuts.gbr, simple-gpsdo-F_Cu.gbr, simple-gpsdo-F_Mask.gbr, simple-gpsdo-F_SilkS.gbr, simple-gpsdo-NPTH.drl]
2021-11-05 added status LED routine to code
2021-11-05 more simulation stuff, changed output filter
    [simple-gpsdo.sch]
2021-11-07 finalized output amplifier design
    added wilkinson divider for dual outputs to improve isolation and amplitude
    [simple-gpsdo.sch]
2021-11-07 more schematic and pcb updates
    finished 10MHz output and fixed LED orientation
    [simple-gpsdo-B_Cu.gbr, simple-gpsdo-B_Mask.gbr, simple-gpsdo-B_SilkS.gbr, simple-gpsdo-Edge_Cuts.gbr, simple-gpsdo-F_Cu.gbr, simple-gpsdo-F_Mask.gbr, simple-gpsdo-F_SilkS.gbr, simple-gpsdo-NPTH.drl]
2021-11-07 schematic for rev E finalized
    [simple-gpsdo-B_Cu.gbr, simple-gpsdo-B_Mask.gbr, simple-gpsdo-B_SilkS.gbr, simple-gpsdo-Edge_Cuts.gbr, simple-gpsdo-F_Cu.gbr, simple-gpsdo-F_Mask.gbr, simple-gpsdo-F_SilkS.gbr, simple-gpsdo-NPTH.drl]
2021-11-09 added more fault information in serial console and LEDs
2021-11-10 added front panel cutouts svg for laser cutting
2021-11-11 updated LED handling
2021-11-11 lengthened pcb by 0.5mm
    [simple-gpsdo-B_Cu.gbr, simple-gpsdo-B_Mask.gbr, simple-gpsdo-B_SilkS.gbr, simple-gpsdo-Edge_Cuts.gbr, simple-gpsdo-F_Cu.gbr, simple-gpsdo-F_Mask.gbr, simple-gpsdo-F_SilkS.gbr, simple-gpsdo-NPTH.drl]
2021-12-07 updated to NMEA parsing and printing
    changed order of value prints, and added parser for GPS time
2021-12-12 Added serial checks to prevent lockup without serial connected
    [lars-code-improved.ino]
2022-11-28 small changes to kicad schematic and FW
    [simple-gpsdo-bom-revE.csv]
