W3AXL/Simple-GPSDO/(notices)

Notices in the files:
kicad/734153980.stp:
FILE_NAME( 'C:/Users/KMIROS~1/AppData/Local/Temp/psolqas_4236_6.stp', '2020-05-06T21:10:16', ( 'License CC BY-ND 4.0' ), ( 'CADENAS' ), ' ', 'PARTsolutions', ' ' );
